meerstern/Usb_Camera_Converter/TestedCamera.csv

*共通注意点*
・SD,SDHC,SDXCまで対応していますが、確認は128GBまで確認済です。
・電源の電流が十分得られない場合、途中で停止する場合や再起動を繰り返す等不安定になる場合があります。1A以上供給可能な電源やUSBケーブルを使用してください。
・セルフパワーのUSBハブ等を介して十分な電流を確保してください。
・動作しないモードの場合にaltやdfi設定を変更することで動作する場合があります
*トリガかけてから保存までの時間を要する場合はdfi設定の値を小さく変更することで改善する場合があります
JpgScale | 0 | 160 | 120
 | 1 | 320 | 240
 | 2 | 640 | 480
 | 3 | 1280 | 960
Logicool C920 |  |  |  | HDMI Video Capture(MS2109) |  |  | ibuffolo BSWHD06M |  |  | Elecom UCAM-C520FBBK |  |  | Logicool C270 |  |  | Logicool C505
形式 | 解像度 | 動作有無 |  | 形式 | 解像度 | 動作有無 | 形式 | 解像度 | 動作有無 | 形式 | 解像度 | 動作有無 | 形式 | 解像度 | 動作有無 | 形式 | 解像度 | 動作有無
BMP | 160x90 | × |  | JPG | 1920x1080 | × | BMP | 320x240 | × | JPG | 1280x720 | 〇 | BMP | 160x120 | 〇 | BMP | 160x120 | 〇
BMP | 160x120 | × |  | JPG | 1600x1200 | × | BMP | 176x144 | 〇 | JPG | 800x600 | 〇 | BMP | 176x144 | 〇 | BMP | 176x144 | 〇
BMP | 176x144 | × |  | JPG | 1360x768 | × | BMP | 160x120 | 〇 | JPG | 640x480 | 〇 | BMP | 320x176 | 〇 | BMP | 320x176 | 〇
BMP | 320x180 | × |  | JPG | 1280x1024 | × | JPG | 1280x960 | 〇 | JPG | 352x288 | 〇 | BMP | 320x240 | 〇 | BMP | 320x240 | 〇
BMP | 320x240 | × |  | JPG | 1280x960 | × | JPG | 1280x720 | 〇 | *BMPはメモリ制約で動作せず |  |  | JPG | 640x480 | 〇 | JPG | 640x480 | 〇
JPG | 640x480 | × |  | JPG | 1280x720 | × | JPG | 800x600 | 〇 |  |  |  | JPG | 160x120 | 〇 | JPG | 160x120 | 〇
JPG | 160x90 | × |  | JPG | 1024x768 | × | JPG | 640x480 | 〇 |  |  |  | JPG | 176x144 | 〇 | JPG | 176x144 | 〇
JPG | 160x120 | × |  | JPG | 800x600 | × | JPG | 640x360 | 〇 |  |  |  | JPG | 320x176 | 〇 | JPG | 320x176 | 〇
JPG | 176x144 | × |  | JPG | 720x576 | × | JPG | 352x288 | 〇 |  |  |  | JPG | 320x240 | 〇 | JPG | 320x240 | 〇
JPG | 320x180 | × |  | JPG | 720x480 | × | JPG | 320x240 | 〇 |  |  |  | JPG | 352x288 | 〇 | JPG | 352x288 | 〇
JPG | 320x240 | × |  | JPG | 640x480 | × | JPG | 176x144 | 〇 |  |  |  | JPG | 432x240 | 〇 | JPG | 432x240 | 〇
JPG | 352x288 | × |  | *データ同期失敗するため、全フォーマットで動作せず |  |  | JPG | 160x120 | 〇 |  |  |  | JPG | 544x288 | 〇 | JPG | 544x288 | 〇
JPG | 432x240 | × |  |  |  |  | *数10回に1回程度、データ破損の場合有 |  |  |  |  |  | JPG | 640x360 | 〇 | JPG | 640x360 | 〇
JPG | 640x360 | × |  |  |  |  |  |  |  |  |  |  | JPG | 752x416 | 〇 | JPG | 752x416 | 〇
JPG | 800x448 | × |  |  |  |  |  |  |  |  |  |  | JPG | 800x448 | 〇 | JPG | 800x448 | 〇
JPG | 800x600 | 〇(alt=9) |  |  |  |  |  |  |  |  |  |  | JPG | 864x480 | 〇 | JPG | 864x480 | 〇
JPG | 864x480 | × |  |  |  |  |  |  |  |  |  |  | JPG | 960x544 | 〇 | JPG | 960x544 | 〇
JPG | 960x720 | × |  |  |  |  |  |  |  |  |  |  | JPG | 960x720 | 〇 | JPG | 960x720 | 〇
JPG | 1024x576 | 〇(alt=9) |  |  |  |  | *** Supported Stream Settings *** |  |  |  |  |  | JPG | 1024x576 | 〇 | JPG | 1024x576 | 〇
JPG | 1280x720 | × |  |  |  |  | Index:5, Format: 1(BMP 4), Frame: 6 (320 x 240) |  |  |  |  |  | JPG | 1184x656 | 〇 | JPG | 1184x656 | 〇
JPG | 1600x896 | × |  |  |  |  | Index:6, Format: 1(BMP 4), Frame: 7 (176 x 144) |  |  |  |  |  | JPG | 1280x720 | 〇 | JPG | 1280x720 | 〇
JPG | 1920x1080 | × |  |  |  |  | Index:7, Format: 1(BMP 4), Frame: 8 (160 x 120) |  |  |  |  |  | JPG | 1280x960 | 〇 | JPG | 1280x960 | 〇
*設定変更後のカメラ側のUSB差し直し必須 |  |  |  |  |  |  | Index:8, Format: 2(JPEG 6), Frame: 1 (1280 x 960)
*電流が大きいため、より安定した電源必須 |  |  |  |  |  |  | Index:9, Format: 2(JPEG 6), Frame: 2 (1280 x 720) |  |  |  |  |  | *電流が大きいため、より安定した電源必須 |  |  | *電流が大きいため、より安定した電源必須
 |  |  |  |  |  |  | Index:10, Format: 2(JPEG 6), Frame: 3 (800 x 600)
*atl=*記載はalt設定を変更することで動作 |  |  |  |  |  |  | Index:11, Format: 2(JPEG 6), Frame: 4 (640 x 480)
 |  |  |  |  |  |  | Index:12, Format: 2(JPEG 6), Frame: 5 (640 x 360) |  |  |  |  |  | *** Supported Stream Settings *** |  |  | *** Supported Stream Settings ***
 |  |  |  |  |  |  | Index:13, Format: 2(JPEG 6), Frame: 6 (352 x 288) |  |  |  |  |  | Index:1, Format: 1(BMP 4), Frame: 2 (160 x 120) |  |  | Index:1, Format: 1(BMP 4), Frame: 2 (160 x 120)
 |  |  |  |  |  |  | Index:14, Format: 2(JPEG 6), Frame: 7 (320 x 240) |  |  |  |  |  | Index:2, Format: 1(BMP 4), Frame: 3 (176 x 144) |  |  | Index:2, Format: 1(BMP 4), Frame: 3 (176 x 144)
 |  |  |  |  |  |  | Index:15, Format: 2(JPEG 6), Frame: 8 (176 x 144) |  |  |  |  |  | Index:3, Format: 1(BMP 4), Frame: 4 (320 x 176) |  |  | Index:3, Format: 1(BMP 4), Frame: 4 (320 x 176)
 |  |  |  |  |  |  | Index:16, Format: 2(JPEG 6), Frame: 9 (160 x 120) |  |  |  |  |  | Index:4, Format: 1(BMP 4), Frame: 5 (320 x 240) |  |  | Index:4, Format: 1(BMP 4), Frame: 5 (320 x 240)
 |  |  |  |  |  |  |  |  |  |  |  |  | Index:19, Format: 2(JPEG 6), Frame: 1 (640 x 480) |  |  | Index:19, Format: 2(JPEG 6), Frame: 1 (640 x 480)
 |  |  |  |  |  |  | *** Supported Alternate Interface *** |  |  |  |  |  | Index:20, Format: 2(JPEG 6), Frame: 2 (160 x 120) |  |  | Index:20, Format: 2(JPEG 6), Frame: 2 (160 x 120)
 |  |  |  |  |  |  | Index:2, Size: 0xC00 byte |  |  |  |  |  | Index:21, Format: 2(JPEG 6), Frame: 3 (176 x 144) |  |  | Index:21, Format: 2(JPEG 6), Frame: 3 (176 x 144)
 |  |  |  |  |  |  | Index:3, Size: 0x400 byte |  |  |  |  |  | Index:22, Format: 2(JPEG 6), Frame: 4 (320 x 176) |  |  | Index:22, Format: 2(JPEG 6), Frame: 4 (320 x 176)
 |  |  |  |  |  |  | Index:4, Size: 0x200 byte |  |  |  |  |  | Index:23, Format: 2(JPEG 6), Frame: 5 (320 x 240) |  |  | Index:23, Format: 2(JPEG 6), Frame: 5 (320 x 240)
 |  |  |  |  |  |  |  |  |  |  |  |  | Index:24, Format: 2(JPEG 6), Frame: 6 (352 x 288) |  |  | Index:24, Format: 2(JPEG 6), Frame: 6 (352 x 288)
 |  |  |  |  |  |  | *** Supported Dataframe Interval *** |  |  |  |  |  | Index:25, Format: 2(JPEG 6), Frame: 7 (432 x 240) |  |  | Index:25, Format: 2(JPEG 6), Frame: 7 (432 x 240)
 |  |  |  |  |  |  | Index:1, Interval: 0x1312D0 msec |  |  |  |  |  | Index:26, Format: 2(JPEG 6), Frame: 8 (544 x 288) |  |  | Index:26, Format: 2(JPEG 6), Frame: 8 (544 x 288)
 |  |  |  |  |  |  |  |  |  |  |  |  | Index:27, Format: 2(JPEG 6), Frame: 9 (640 x 360) |  |  | Index:27, Format: 2(JPEG 6), Frame: 9 (640 x 360)
 |  |  |  |  |  |  |  |  |  |  |  |  | Index:28, Format: 2(JPEG 6), Frame: 10 (752 x 416) |  |  | Index:28, Format: 2(JPEG 6), Frame: 10 (752 x 416)
 |  |  |  |  |  |  |  |  |  |  |  |  | Index:29, Format: 2(JPEG 6), Frame: 11 (800 x 448) |  |  | Index:29, Format: 2(JPEG 6), Frame: 11 (800 x 448)
 |  |  |  |  |  |  |  |  |  |  |  |  | Index:30, Format: 2(JPEG 6), Frame: 12 (800 x 600) |  |  | Index:30, Format: 2(JPEG 6), Frame: 12 (800 x 600)
 |  |  |  |  |  |  |  |  |  |  |  |  | Index:31, Format: 2(JPEG 6), Frame: 13 (864 x 480) |  |  | Index:31, Format: 2(JPEG 6), Frame: 13 (864 x 480)
 |  |  |  |  |  |  |  |  |  |  |  |  | Index:32, Format: 2(JPEG 6), Frame: 14 (960 x 544) |  |  | Index:32, Format: 2(JPEG 6), Frame: 14 (960 x 544)
 |  |  |  |  |  |  |  |  |  |  |  |  | Index:33, Format: 2(JPEG 6), Frame: 15 (960 x 720) |  |  | Index:33, Format: 2(JPEG 6), Frame: 15 (960 x 720)
 |  |  |  |  |  |  |  |  |  |  |  |  | Index:34, Format: 2(JPEG 6), Frame: 16 (1024 x 576) |  |  | Index:34, Format: 2(JPEG 6), Frame: 16 (1024 x 576)
 |  |  |  |  |  |  |  |  |  |  |  |  | Index:35, Format: 2(JPEG 6), Frame: 17 (1184 x 656) |  |  | Index:35, Format: 2(JPEG 6), Frame: 17 (1184 x 656)
 |  |  |  |  |  |  |  |  |  |  |  |  | Index:36, Format: 2(JPEG 6), Frame: 18 (1280 x 720) |  |  | Index:36, Format: 2(JPEG 6), Frame: 18 (1280 x 720)
 |  |  |  |  |  |  |  |  |  |  |  |  | Index:37, Format: 2(JPEG 6), Frame: 19 (1280 x 960) |  |  | Index:37, Format: 2(JPEG 6), Frame: 19 (1280 x 960)
 |  |  |  |  |  |  |  |  |  |  |  |  | *** Supported Alternate Interface *** |  |  | *** Supported Alternate Interface ***
 |  |  |  |  |  |  |  |  |  |  |  |  | Index:1, Size: 0xC0 byte |  |  | Index:1, Size: 0xC0 byte
 |  |  |  |  |  |  |  |  |  |  |  |  | Index:2, Size: 0x180 byte |  |  | Index:2, Size: 0x180 byte
 |  |  |  |  |  |  |  |  |  |  |  |  | Index:3, Size: 0x200 byte |  |  | Index:3, Size: 0x200 byte
 |  |  |  |  |  |  |  |  |  |  |  |  | Index:4, Size: 0x280 byte |  |  | Index:4, Size: 0x280 byte
 |  |  |  |  |  |  |  |  |  |  |  |  | Index:5, Size: 0x320 byte |  |  | Index:5, Size: 0x320 byte
 |  |  |  |  |  |  |  |  |  |  |  |  | Index:6, Size: 0x3B0 byte |  |  | Index:6, Size: 0x3B0 byte
 |  |  |  |  |  |  |  |  |  |  |  |  | Index:7, Size: 0xA80 byte |  |  | Index:7, Size: 0xA80 byte
 |  |  |  |  |  |  |  |  |  |  |  |  | Index:8, Size: 0xB20 byte |  |  | Index:8, Size: 0xB20 byte
 |  |  |  |  |  |  |  |  |  |  |  |  | Index:9, Size: 0xBE0 byte |  |  | Index:9, Size: 0xBE0 byte
 |  |  |  |  |  |  |  |  |  |  |  |  | *** Supported Dataframe Interval *** |  |  | *** Supported Dataframe Interval ***
 |  |  |  |  |  |  |  |  |  |  |  |  | Index:1, Interval: 0x51615 msec |  |  | Index:1, Interval: 0x51615 msec
 |  |  |  |  |  |  |  |  |  |  |  |  | Index:2, Interval: 0x61A80 msec |  |  | Index:2, Interval: 0x61A80 msec
 |  |  |  |  |  |  |  |  |  |  |  |  | Index:3, Interval: 0x7A120 msec |  |  | Index:3, Interval: 0x7A120 msec
 |  |  |  |  |  |  |  |  |  |  |  |  | Index:4, Interval: 0xA2C2A msec |  |  | Index:4, Interval: 0xA2C2A msec
 |  |  |  |  |  |  |  |  |  |  |  |  | Index:5, Interval: 0xF4240 msec |  |  | Index:5, Interval: 0xF4240 msec
 |  |  |  |  |  |  |  |  |  |  |  |  | Index:6, Interval: 0x1E8480 msec |  |  | Index:6, Interval: 0x1E8480 msec
