meerstern/Usb_Camera_Converter/PCB/Circuit.pdf

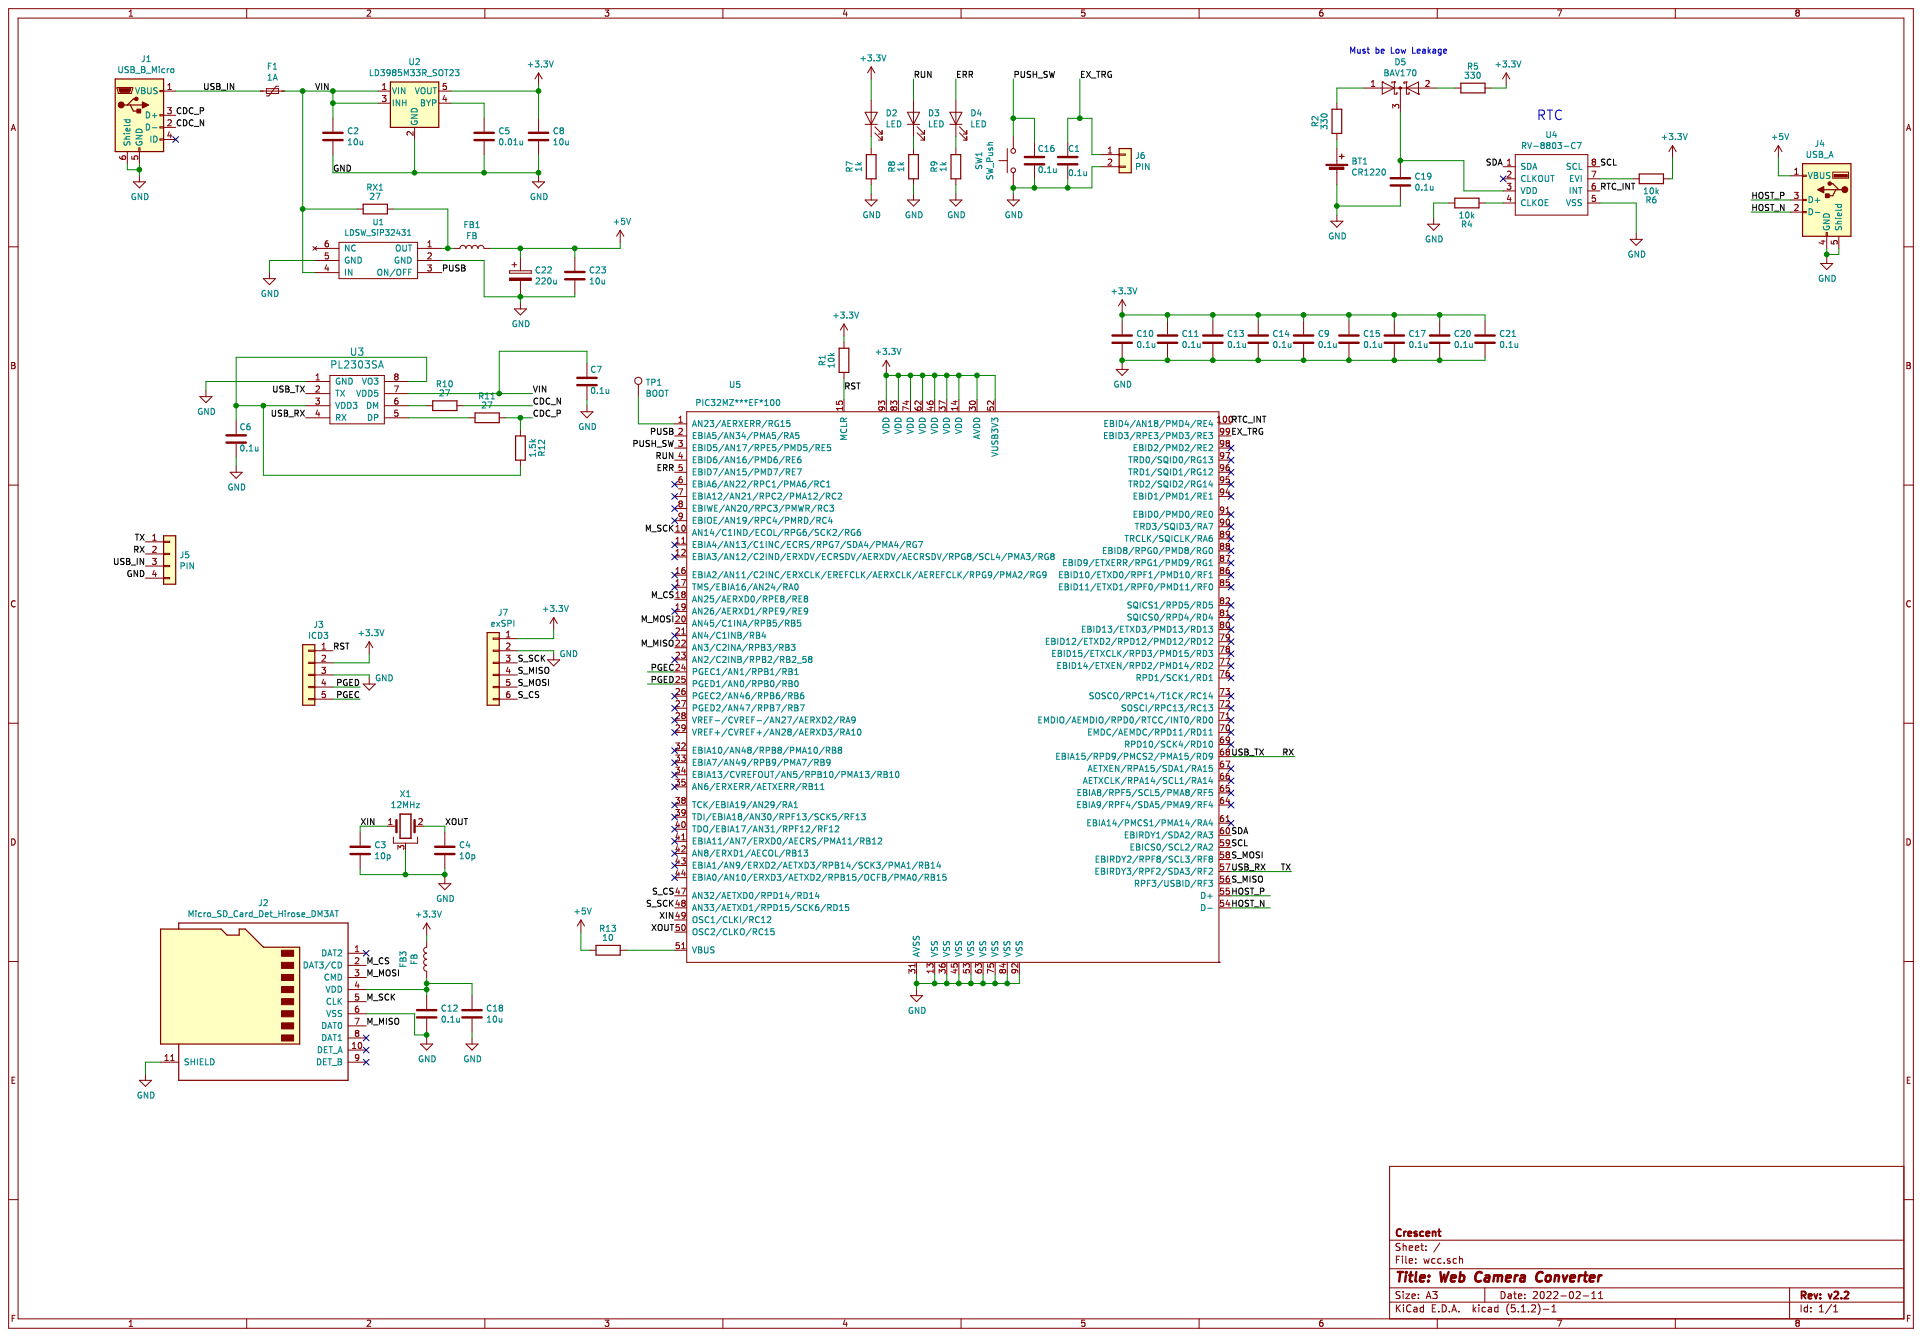
[picture p8: page 1]
