meerstern/Usb_Camera_Converter/(list of files, drawings)

Other design files:
PCB/wcc.dsn
