meerstern/Usb_Camera_Converter/PCB/wcc.kicad_pcb

## KiCad design PCB/wcc.kicad_pcb (2022-03-23)

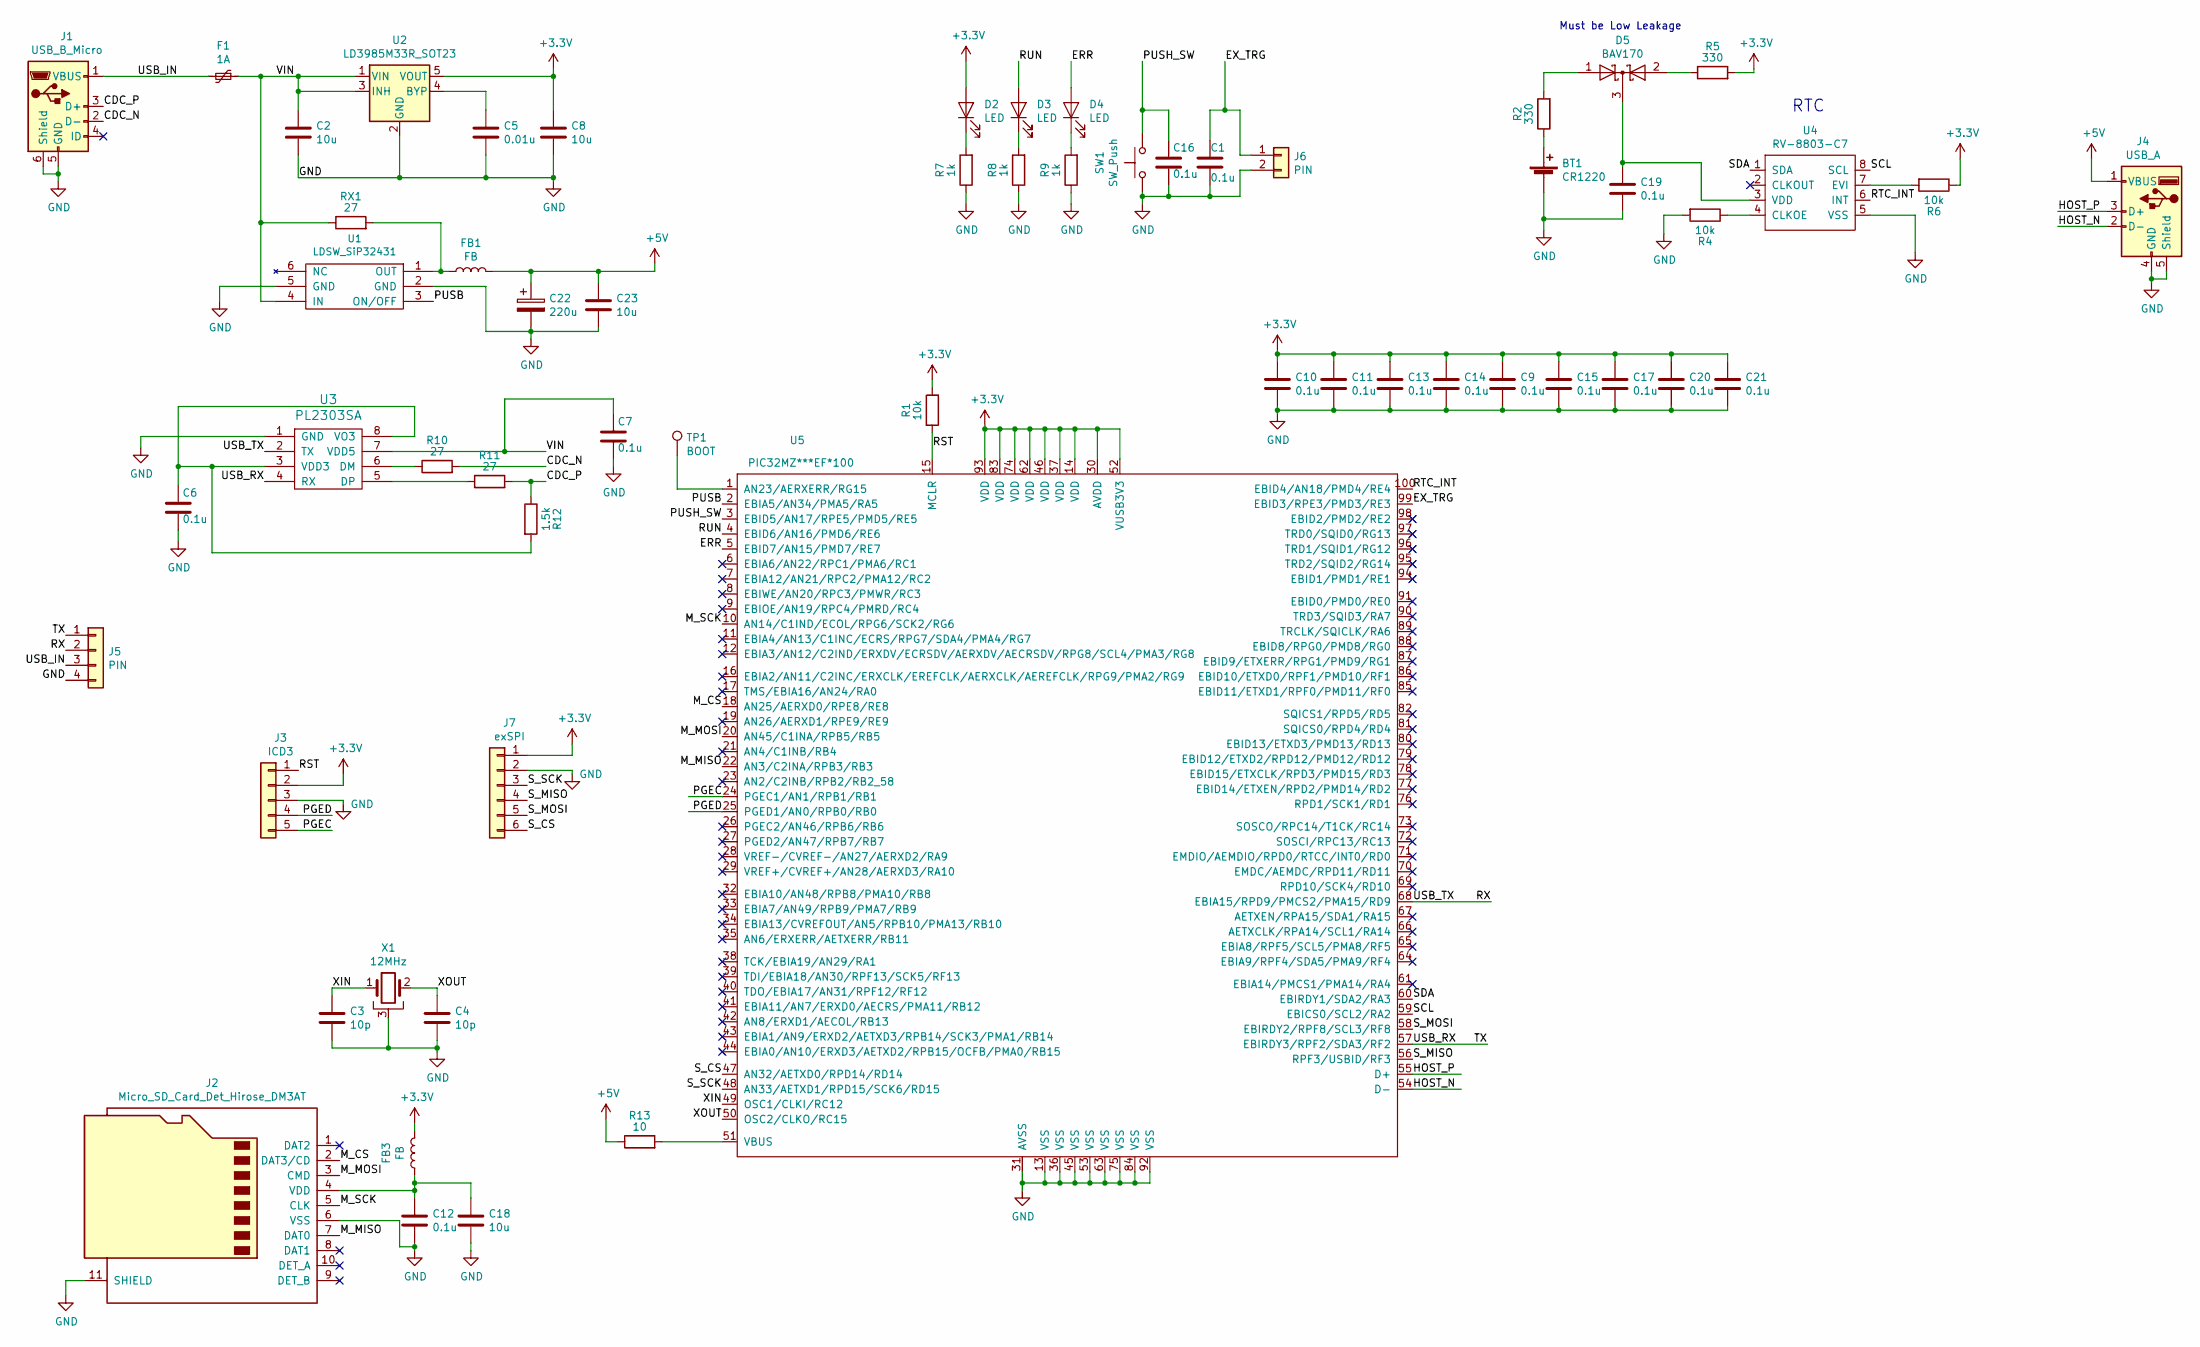
[picture p9: schematic wcc.sch, Web Camera Converter]

Parts:
BT1: CR1220; 2895
C1, C6, C7, C9, C10, C11, C12, C13, C14, C15, C16, C17, C19, C20, C21: 0.1u; C_0603_1608Metric
C2, C8, C18, C23: 10u; C_0805_2012Metric
C3, C4: 10p; C_0603_1608Metric
C5: 0.01u; C_0603_1608Metric
C22: 220u; CP_Elec_6.3x5.4_Nichicon
D2, D3, D4: LED; D_0603_1608Metric
D5: BAV170; SOT-23
F1: 1A; Fuse_1210_3225Metric
FB1, FB3: FB; L_0603_1608Metric
J1: USB_B_Micro; CONN-10118194-0001LF-FCI
J2: Micro_SD_Card_Det_Hirose_DM3AT; microSD_HC_Hirose_DM3AT-SF-PEJM5
J3: ICD3; PinHeader_1x05_P2.54mm_Vertical
J4: USB_A; USBHOST
J5: PIN; PinHeader_1x04_P2.54mm_Vertical
J6: PIN; PinHeader_1x02_P2.54mm_Vertical
J7: exSPI; PinHeader_1x06_P2.54mm_Vertical
R1, R4, R6: 10k; R_0603_1608Metric
R2, R5: 330; R_0603_1608Metric
R7, R8, R9: 1k; R_0603_1608Metric
R10, R11: 27; R_0603_1608Metric
R12: 1.5k; R_0603_1608Metric
R13: 10; R_0603_1608Metric
RX1: 27; R_0603_1608Metric
SW1: SW_Push; SKRPACE010
TP1: BOOT; TestPoint_Pad_D1.0mm
U1: LDSW_SiP32431; SOT-363_SC-70-6
U2: LD3985M33R_SOT23; SOT-23-5
U3: PL2303SA; SOIC-8_3.9x4.9mm_P1.27mm
U4: RV-8803-C7
U5: PIC32MZ***EF*100; TQFP-100_12x12mm_P0.4mm
X1: 12MHz; FA238V

Connections:
+3V3: C8.1, C9.1, C10.1, C11.1, C13.1, C14.1, C15.1, C17.1, C20.1, C21.1, D2.2 (A), FB3.2, J3.2, J7.1, R1.2, R5.2, R6.1, U2.5 (VOUT), U5.14 (VDD), U5.30 (AVDD), U5.37 (VDD), U5.46 (VDD), U5.52 (VUSB3V3), U5.62 (VDD), U5.74 (VDD), U5.83 (VDD), U5.93 (VDD)
+5V: C22.1, C23.1, FB1.2, J4.1 (VBUS), R13.1
/CDC_N: J1.2 (D-), R10.2
/CDC_P: J1.3 (D+), R11.2, R12.1
/ERR: D4.2 (A), U5.5 (EBID7/AN15/PMD7/RE7)
/EX_TRG: C1.1, J6.1, U5.99 (EBID3/RPE3/PMD3/RE3)
/HOST_N: J4.2 (D-), U5.54 (D-)
/HOST_P: J4.3 (D+), U5.55 (D+)
/M_CS: J2.2 (DAT3/CD), U5.18 (AN25/AERXD0/RPE8/RE8)
/M_MISO: J2.7 (DAT0), U5.22 (AN3/C2INA/RPB3/RB3)
/M_MOSI: J2.3 (CMD), U5.20 (AN45/C1INA/RPB5/RB5)
/M_SCK: J2.5 (CLK), U5.10 (AN14/C1IND/ECOL/RPG6/SCK2/RG6)
/PGEC: J3.5, U5.24 (PGEC1/AN1/RPB1/RB1)
/PGED: J3.4, U5.25 (PGED1/AN0/RPB0/RB0)
/PUSB: U1.3 (ON/OFF), U5.2 (EBIA5/AN34/PMA5/RA5)
/PUSH_SW: C16.1, SW1.2, U5.3 (EBID5/AN17/RPE5/PMD5/RE5)
/RST: J3.1, R1.1, U5.15 (MCLR)
/RTC_INT: U4.6 (INT), U5.100 (EBID4/AN18/PMD4/RE4)
/RUN: D3.2 (A), U5.4 (EBID6/AN16/PMD6/RE6)
/RX: J5.2, U3.2 (TX), U5.68 (EBIA15/RPD9/PMCS2/PMA15/RD9)
/SCL: U4.8 (SCL), U5.59 (EBICS0/SCL2/RA2)
/SDA: U4.1 (SDA), U5.60 (EBIRDY1/SDA2/RA3)
/S_CS: J7.6, U5.47 (AN32/AETXD0/RPD14/RD14)
/S_MISO: J7.4, U5.56 (RPF3/USBID/RF3)
/S_MOSI: J7.5, U5.58 (EBIRDY2/RPF8/SCL3/RF8)
/S_SCK: J7.3, U5.48 (AN33/AETXD1/RPD15/SCK6/RD15)
/TX: J5.1, U3.4 (RX), U5.57 (EBIRDY3/RPF2/SDA3/RF2)
/USB_IN: F1.2, J1.1 (VBUS), J5.3
/VIN: C2.1, C7.1, F1.1, RX1.1, U1.4 (IN), U2.1 (VIN), U2.3 (INH), U3.7 (VDD5)
/XIN: C3.1, U5.49 (OSC1/CLKI/RC12), X1.1
/XOUT: C4.1, U5.50 (OSC2/CLKO/RC15), X1.2
GND: BT1.2 (-), C1.2, C2.2, C3.2, C4.2, C5.2, C6.2, C7.2, C8.2, C9.2, C10.2, C11.2, C12.2, C13.2, C14.2, C15.2, C16.2, C17.2, C18.2, C19.2, C20.2, C21.2, C22.2, C23.2, J1.5 (GND), J1.6 (Shield), J2.6 (VSS), J2.11 (SHIELD), J3.3, J4.4 (GND), J4.5 (Shield), J5.4, J6.2, J7.2, R4.2, R7.1, R8.1, R9.1, SW1.1, U1.2 (GND), U1.5 (GND), U2.2 (GND), U3.1 (GND), U4.5 (VSS), U5.13 (VSS), U5.31 (AVSS), U5.36 (VSS), U5.45 (VSS), U5.53 (VSS), U5.63 (VSS), U5.75 (VSS), U5.84 (VSS), U5.92 (VSS), X1.3
unnamed: BT1.1 (+), R2.1
unnamed: C5.1, U2.4 (BYP)
unnamed: C6.1, R12.2, U3.3 (VDD3), U3.8 (VO3)
unnamed: C12.1, C18.1, FB3.1, J2.4 (VDD)
unnamed: C19.1, D5.3 (K), U4.3 (VDD)
unnamed: D2.1 (K), R7.2
unnamed: D3.1 (K), R8.2
unnamed: D4.1 (K), R9.2
unnamed: D5.1 (A), R2.2
unnamed: D5.2 (A), R5.1
unnamed: FB1.1, RX1.2, U1.1 (OUT)
unnamed: R4.1, U4.4 (CLKOE)
unnamed: R6.2, U4.7 (EVI)
unnamed: R10.1, U3.6 (DM)
unnamed: R11.1, U3.5 (DP)
unnamed: R13.2, U5.51 (VBUS)
unnamed: TP1.1, U5.1 (AN23/AERXERR/RG15)

Notes on the sheet:
RTC
Must be Low Leakage

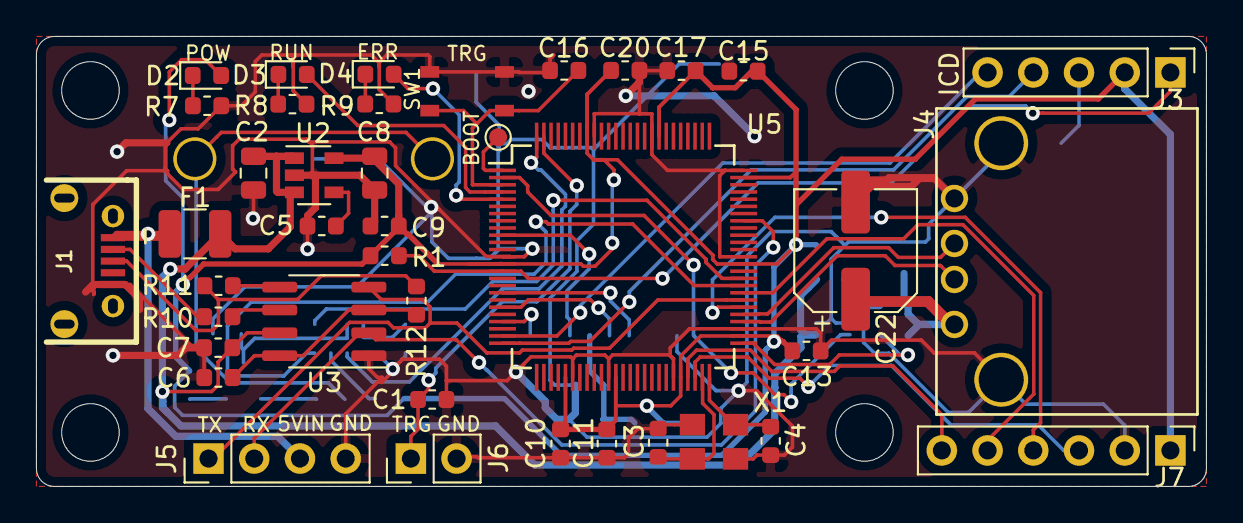
[picture p10: board wcc.kicad_pcb from above]

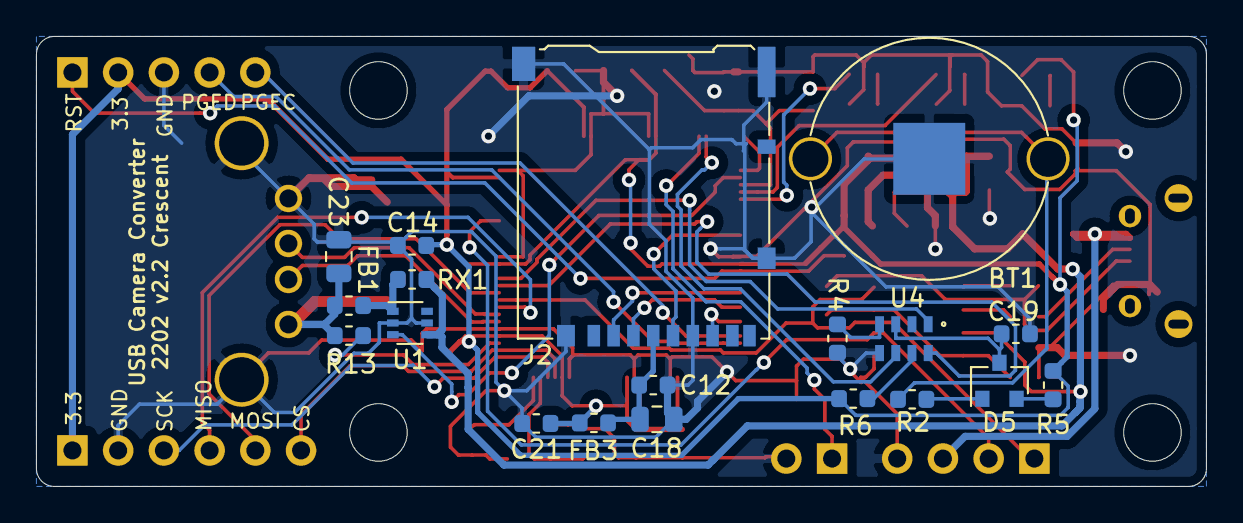
[picture p11: board wcc.kicad_pcb from below]

Board: 2 copper layers, 65.0 x 25.0 mm, 63 parts (19 on the bottom side), 49 nets.

Other parts of the board:
REF1, REF2, REF3, REF4: MountingHole_3.2mm_M3
