meerstern/Usb_Camera_Converter/FIRM/Application/firmware/src/config/default/initialization.c

/*******************************************************************************
  System Initialization File

  File Name:
    initialization.c

  Summary:
    This file contains source code necessary to initialize the system.

  Description:
    This file contains source code necessary to initialize the system.  It
    implements the "SYS_Initialize" function, defines the configuration bits,
    and allocates any necessary global system resources,
 *******************************************************************************/

// DOM-IGNORE-BEGIN
/*******************************************************************************
* Copyright (C) 2018 Microchip Technology Inc. and its subsidiaries.
*
* Subject to your compliance with these terms, you may use Microchip software
* and any derivatives exclusively with Microchip products. It is your
* responsibility to comply with third party license terms applicable to your
* use of third party software (including open source software) that may
* accompany Microchip software.
*
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
* IN NO EVENT WILL MICROCHIP BE LIABLE FOR ANY INDIRECT, SPECIAL, PUNITIVE,
* INCIDENTAL OR CONSEQUENTIAL LOSS, DAMAGE, COST OR EXPENSE OF ANY KIND
* WHATSOEVER RELATED TO THE SOFTWARE, HOWEVER CAUSED, EVEN IF MICROCHIP HAS
* BEEN ADVISED OF THE POSSIBILITY OR THE DAMAGES ARE FORESEEABLE. TO THE
* FULLEST EXTENT ALLOWED BY LAW, MICROCHIP'S TOTAL LIABILITY ON ALL CLAIMS IN
* ANY WAY RELATED TO THIS SOFTWARE WILL NOT EXCEED THE AMOUNT OF FEES, IF ANY,
* THAT YOU HAVE PAID DIRECTLY TO MICROCHIP FOR THIS SOFTWARE.
 *******************************************************************************/
// DOM-IGNORE-END

// *****************************************************************************
// *****************************************************************************
// Section: Included Files
// *****************************************************************************
// *****************************************************************************
#include "configuration.h"
#include "definitions.h"
#include "device.h"
#include "driver/spi/src/drv_spi_local.h"


// ****************************************************************************
// ****************************************************************************
// Section: Configuration Bits
// ****************************************************************************
// ****************************************************************************

/*** DEVCFG0 ***/
#pragma config DEBUG =      OFF
#pragma config JTAGEN =     OFF
#pragma config ICESEL =     ICS_PGx1
#pragma config TRCEN =      OFF
#pragma config BOOTISA =    MIPS32
#pragma config FECCCON =    OFF_UNLOCKED
#pragma config FSLEEP =     OFF
#pragma config DBGPER =     PG_ALL
#pragma config SMCLR =      MCLR_NORM
#pragma config SOSCGAIN =   GAIN_LEVEL_3
#pragma config SOSCBOOST =  ON
#pragma config POSCGAIN =   GAIN_LEVEL_3
#pragma config POSCBOOST =  ON
#pragma config EJTAGBEN =   NORMAL
#pragma config CP =         OFF

/*** DEVCFG1 ***/
#pragma config FNOSC =      SPLL
#pragma config DMTINTV =    WIN_127_128
#pragma config FSOSCEN =    OFF
#pragma config IESO =       OFF
#pragma config POSCMOD =    HS
#pragma config OSCIOFNC =   OFF
#pragma config FCKSM =      CSECME
#pragma config WDTPS =      PS16384
#pragma config WDTSPGM =    STOP
#pragma config FWDTEN =     OFF
#pragma config WINDIS =     NORMAL
#pragma config FWDTWINSZ =  WINSZ_25
#pragma config DMTCNT =     DMT31
#pragma config FDMTEN =     OFF

/*** DEVCFG2 ***/
#pragma config FPLLIDIV =   DIV_1
#pragma config FPLLRNG =    RANGE_5_10_MHZ
#pragma config FPLLICLK =   PLL_FRC
#pragma config FPLLMULT =   MUL_50
#pragma config FPLLODIV =   DIV_2
#pragma config UPLLFSEL =   FREQ_12MHZ

/*** DEVCFG3 ***/
#pragma config USERID =     0xffff
#pragma config FMIIEN =     OFF
#pragma config FETHIO =     OFF
#pragma config PGL1WAY =    OFF
#pragma config PMDL1WAY =   OFF
#pragma config IOL1WAY =    OFF
#pragma config FUSBIDIO =   OFF

/*** BF1SEQ0 ***/

#pragma config TSEQ =       0xffff
#pragma config CSEQ =       0x0





// *****************************************************************************
// *****************************************************************************
// Section: Driver Initialization Data
// *****************************************************************************
// *****************************************************************************
// <editor-fold defaultstate="collapsed" desc="DRV_SDSPI Instance 0 Initialization Data">

/* SDSPI Client Objects Pool */
static DRV_SDSPI_CLIENT_OBJ drvSDSPI0ClientObjPool[DRV_SDSPI_CLIENTS_NUMBER_IDX0];

/* SDSPI Transfer Objects Pool */
static DRV_SDSPI_BUFFER_OBJ drvSDSPI0TransferObjPool[DRV_SDSPI_QUEUE_SIZE_IDX0];

/* SPI PLIB Interface Initialization for SDSPI Driver */
const DRV_SDSPI_PLIB_INTERFACE drvSDSPI0PlibAPI = {

    /* SPI PLIB WriteRead function */
    .writeRead = (DRV_SDSPI_PLIB_WRITEREAD)SPI2_WriteRead,

    /* SPI PLIB Write function */
    .write = (DRV_SDSPI_PLIB_WRITE)SPI2_Write,

    /* SPI PLIB Read function */
    .read = (DRV_SDSPI_PLIB_READ)SPI2_Read,

    /* SPI PLIB Transfer Status function */
    .isBusy = (DRV_SDSPI_PLIB_IS_BUSY)SPI2_IsBusy,

    .transferSetup = (DRV_SDSPI_PLIB_SETUP)SPI2_TransferSetup,

    /* SPI PLIB Callback Register */
    .callbackRegister = (DRV_SDSPI_PLIB_CALLBACK_REGISTER)SPI2_CallbackRegister,
};

const uint32_t drvSDSPI0remapDataBits[]= { 0x00000000, 0xFFFFFFFF, 0xFFFFFFFF, 0xFFFFFFFF, 0xFFFFFFFF, 0xFFFFFFFF, 0xFFFFFFFF, 0xFFFFFFFF, 0x00000400 };
const uint32_t drvSDSPI0remapClockPolarity[] = { 0x00000000, 0x00000040 };
const uint32_t drvSDSPI0remapClockPhase[] = { 0x00000000, 0x00000100 };

/* SDSPI Driver Initialization Data */
const DRV_SDSPI_INIT drvSDSPI0InitData =
{
    /* SD Card SPI PLIB API interface*/
    .spiPlib                = &drvSDSPI0PlibAPI,

    .remapDataBits          = drvSDSPI0remapDataBits,

    .remapClockPolarity     = drvSDSPI0remapClockPolarity,

    .remapClockPhase        = drvSDSPI0remapClockPhase,


    /* SDSPI Number of clients */
    .numClients             = DRV_SDSPI_CLIENTS_NUMBER_IDX0,

    /* SDSPI Client Objects Pool */
    .clientObjPool          = (uintptr_t)&drvSDSPI0ClientObjPool[0],

    /* SDSPI Transfer Objects Pool */
    .bufferObjPool          = (uintptr_t)&drvSDSPI0TransferObjPool[0],

    /* SDSPI Transfer Objects Queue Size */
    .bufferObjPoolSize      = DRV_SDSPI_QUEUE_SIZE_IDX0,

    .chipSelectPin          = DRV_SDSPI_CHIP_SELECT_PIN_IDX0,

    .sdcardSpeedHz          = DRV_SDSPI_SPEED_HZ_IDX0,

    .pollingIntervalMs      = DRV_SDSPI_POLLING_INTERVAL_MS_IDX0,

    .writeProtectPin        = SYS_PORT_PIN_NONE,

    .isFsEnabled            = true,

    /* DMA Channel for Transmit */
    .txDMAChannel           = DRV_SDSPI_XMIT_DMA_CH_IDX0,

    /* DMA Channel for Receive */
    .rxDMAChannel           = DRV_SDSPI_RCV_DMA_CH_IDX0,

    /* SPI Transmit Register */
    .txAddress              = (void *)&(SPI2BUF),

    /* SPI Receive Register */
    .rxAddress              = (void *)&(SPI2BUF),
};

// </editor-fold>

// <editor-fold defaultstate="collapsed" desc="DRV_SPI Instance 0 Initialization Data">

/* SPI Client Objects Pool */
static DRV_SPI_CLIENT_OBJ drvSPI0ClientObjPool[DRV_SPI_CLIENTS_NUMBER_IDX0];

/* SPI Transfer Objects Pool */
static DRV_SPI_TRANSFER_OBJ drvSPI0TransferObjPool[DRV_SPI_QUEUE_SIZE_IDX0];

/* SPI PLIB Interface Initialization */
const DRV_SPI_PLIB_INTERFACE drvSPI0PlibAPI = {

    /* SPI PLIB Setup */
    .setup = (DRV_SPI_PLIB_SETUP)SPI6_TransferSetup,

    /* SPI PLIB WriteRead function */
    .writeRead = (DRV_SPI_PLIB_WRITE_READ)SPI6_WriteRead,

    /* SPI PLIB Transfer Status function */
    .isBusy = (DRV_SPI_PLIB_IS_BUSY)SPI6_IsBusy,

    /* SPI PLIB Callback Register */
    .callbackRegister = (DRV_SPI_PLIB_CALLBACK_REGISTER)SPI6_CallbackRegister,
};

const uint32_t drvSPI0remapDataBits[]= { 0x00000000, 0xFFFFFFFF, 0xFFFFFFFF, 0xFFFFFFFF, 0xFFFFFFFF, 0xFFFFFFFF, 0xFFFFFFFF, 0xFFFFFFFF, 0x00000400 };
const uint32_t drvSPI0remapClockPolarity[] = { 0x00000000, 0x00000040 };
const uint32_t drvSPI0remapClockPhase[] = { 0x00000000, 0x00000100 };

const DRV_SPI_INTERRUPT_SOURCES drvSPI0InterruptSources =
{
    /* Peripheral has more than one interrupt vectors */
    .isSingleIntSrc                        = false,

    /* Peripheral interrupt lines */
    .intSources.multi.spiTxReadyInt      = -1,
    .intSources.multi.spiTxCompleteInt   = _SPI6_TX_VECTOR,
    .intSources.multi.spiRxInt           = _SPI6_RX_VECTOR,
};

/* SPI Driver Initialization Data */
const DRV_SPI_INIT drvSPI0InitData =
{
    /* SPI PLIB API */
    .spiPlib = &drvSPI0PlibAPI,

    .remapDataBits = drvSPI0remapDataBits,

    .remapClockPolarity = drvSPI0remapClockPolarity,

    .remapClockPhase = drvSPI0remapClockPhase,

    /* SPI Number of clients */
    .numClients = DRV_SPI_CLIENTS_NUMBER_IDX0,

    /* SPI Client Objects Pool */
    .clientObjPool = (uintptr_t)&drvSPI0ClientObjPool[0],

    /* DMA Channel for Transmit */
    .dmaChannelTransmit = SYS_DMA_CHANNEL_NONE,

    /* DMA Channel for Receive */
    .dmaChannelReceive  = SYS_DMA_CHANNEL_NONE,

    /* SPI Queue Size */
    .transferObjPoolSize = DRV_SPI_QUEUE_SIZE_IDX0,

    /* SPI Transfer Objects Pool */
    .transferObjPool = (uintptr_t)&drvSPI0TransferObjPool[0],

    /* SPI interrupt sources (SPI peripheral and DMA) */
    .interruptSources = &drvSPI0InterruptSources,
};

// </editor-fold>


// *****************************************************************************
// *****************************************************************************
// Section: System Data
// *****************************************************************************
// *****************************************************************************
/* Structure to hold the object handles for the modules in the system. */
SYSTEM_OBJECTS sysObj;

// *****************************************************************************
// *****************************************************************************
// Section: Library/Stack Initialization Data
// *****************************************************************************
// *****************************************************************************
/******************************************************
 * USB Driver Initialization
 ******************************************************/
//uint8_t __attribute__((aligned(512))) endPointTable1[DRV_USBHS_ENDPOINTS_NUMBER * 32];


const DRV_USBHS_INIT drvUSBInit =
{
    /* Assign the endpoint table */
    //.endpointTable= endPointTable1,
    
    /* Interrupt Source for USB module */
    .interruptSource = INT_SOURCE_USB,

	/* Interrupt Source for USB module */
    .interruptSourceUSBDma = INT_SOURCE_USB_DMA,
	
    /* System module initialization */
    .moduleInit = {0},

	/* USB Controller to operate as USB Host */
    .operationMode = DRV_USBHS_OPMODE_HOST,

	/* Enable High Speed Operation */
    .operationSpeed = USB_SPEED_HIGH,
    
    /* Stop in idle */
    .stopInIdle = true,

    /* Suspend in sleep */
    .suspendInSleep = false,

    /* Identifies peripheral (PLIB-level) ID */
    .usbID = USBHS_ID_0,
	
	.portPowerEnable = NULL,
	
    /* Root hub available current in milliamperes */
    .rootHubAvailableCurrent = 500,
};


// <editor-fold defaultstate="collapsed" desc="File System Initialization Data">


const SYS_FS_MEDIA_MOUNT_DATA sysfsMountTable[SYS_FS_VOLUME_NUMBER] =
{
    {NULL}
};

const SYS_FS_FUNCTIONS FatFsFunctions =
{
    .mount             = FATFS_mount,
    .unmount           = FATFS_unmount,
    .open              = FATFS_open,
    .read              = FATFS_read,
    .close             = FATFS_close,
    .seek              = FATFS_lseek,
    .fstat             = FATFS_stat,
    .getlabel          = FATFS_getlabel,
    .currWD            = FATFS_getcwd,
    .getstrn           = FATFS_gets,
    .openDir           = FATFS_opendir,
    .readDir           = FATFS_readdir,
    .closeDir          = FATFS_closedir,
    .chdir             = FATFS_chdir,
    .chdrive           = FATFS_chdrive,
    .write             = FATFS_write,
    .tell              = FATFS_tell,
    .eof               = FATFS_eof,
    .size              = FATFS_size,
    .mkdir             = FATFS_mkdir,
    .remove            = FATFS_unlink,
    .setlabel          = FATFS_setlabel,
    .truncate          = FATFS_truncate,
    .chmode            = FATFS_chmod,
    .chtime            = FATFS_utime,
    .rename            = FATFS_rename,
    .sync              = FATFS_sync,
    .putchr            = FATFS_putc,
    .putstrn           = FATFS_puts,
    .formattedprint    = FATFS_printf,
    .testerror         = FATFS_error,
    .formatDisk        = (FORMAT_DISK)FATFS_mkfs,
    .partitionDisk     = FATFS_fdisk,
    .getCluster        = FATFS_getclusters
};


const SYS_FS_REGISTRATION_TABLE sysFSInit [ SYS_FS_MAX_FILE_SYSTEM_TYPE ] =
{
    {
        .nativeFileSystemType = FAT,
        .nativeFileSystemFunctions = &FatFsFunctions
    }
};

// </editor-fold>



// *****************************************************************************
// *****************************************************************************
// Section: System Initialization
// *****************************************************************************
// *****************************************************************************

const SYS_DEBUG_INIT debugInit =
{
    .moduleInit = {0},
    .errorLevel = SYS_DEBUG_GLOBAL_ERROR_LEVEL,
    .consoleIndex = 0,
};


// <editor-fold defaultstate="collapsed" desc="SYS_TIME Initialization Data">

const SYS_TIME_PLIB_INTERFACE sysTimePlibAPI = {
    .timerCallbackSet = (SYS_TIME_PLIB_CALLBACK_REGISTER)CORETIMER_CallbackSet,
    .timerStart = (SYS_TIME_PLIB_START)CORETIMER_Start,
    .timerStop = (SYS_TIME_PLIB_STOP)CORETIMER_Stop ,
    .timerFrequencyGet = (SYS_TIME_PLIB_FREQUENCY_GET)CORETIMER_FrequencyGet,
    .timerPeriodSet = (SYS_TIME_PLIB_PERIOD_SET)NULL,
    .timerCompareSet = (SYS_TIME_PLIB_COMPARE_SET)CORETIMER_CompareSet,
    .timerCounterGet = (SYS_TIME_PLIB_COUNTER_GET)CORETIMER_CounterGet,
};

const SYS_TIME_INIT sysTimeInitData =
{
    .timePlib = &sysTimePlibAPI,
    .hwTimerIntNum = 0,
};

// </editor-fold>
// <editor-fold defaultstate="collapsed" desc="SYS_CONSOLE Instance 0 Initialization Data">


/* Declared in console device implementation (sys_console_uart.c) */
extern const SYS_CONSOLE_DEV_DESC sysConsoleUARTDevDesc;

const SYS_CONSOLE_UART_PLIB_INTERFACE sysConsole0UARTPlibAPI =
{
    .read = (SYS_CONSOLE_UART_PLIB_READ)UART2_Read,
	.readCountGet = (SYS_CONSOLE_UART_PLIB_READ_COUNT_GET)UART2_ReadCountGet,
	.readFreeBufferCountGet = (SYS_CONSOLE_UART_PLIB_READ_FREE_BUFFFER_COUNT_GET)UART2_ReadFreeBufferCountGet,
    .write = (SYS_CONSOLE_UART_PLIB_WRITE)UART2_Write,
	.writeCountGet = (SYS_CONSOLE_UART_PLIB_WRITE_COUNT_GET)UART2_WriteCountGet,
	.writeFreeBufferCountGet = (SYS_CONSOLE_UART_PLIB_WRITE_FREE_BUFFER_COUNT_GET)UART2_WriteFreeBufferCountGet,
};

const SYS_CONSOLE_UART_INIT_DATA sysConsole0UARTInitData =
{
    .uartPLIB = &sysConsole0UARTPlibAPI,    
};

const SYS_CONSOLE_INIT sysConsole0Init =
{
    .deviceInitData = (const void*)&sysConsole0UARTInitData,
    .consDevDesc = &sysConsoleUARTDevDesc,
    .deviceIndex = 0,
};



// </editor-fold>




// *****************************************************************************
// *****************************************************************************
// Section: Local initialization functions
// *****************************************************************************
// *****************************************************************************



/*******************************************************************************
  Function:
    void SYS_Initialize ( void *data )

  Summary:
    Initializes the board, services, drivers, application and other modules.

  Remarks:
 */

void SYS_Initialize ( void* data )
{

    /* Start out with interrupts disabled before configuring any modules */
    __builtin_disable_interrupts();

  
    CLK_Initialize();
    
    /* Configure Prefetch, Wait States and ECC */
    PRECONbits.PREFEN = 3;
    PRECONbits.PFMWS = 3;
    CFGCONbits.ECCCON = 3;



	GPIO_Initialize();

    DMAC_Initialize();

	SPI6_Initialize();

    CORETIMER_Initialize();
    I2C2_Initialize();

	UART2_Initialize();

	SPI2_Initialize();


    /* Initialize SDSPI0 Driver Instance */
    sysObj.drvSDSPI0 = DRV_SDSPI_Initialize(DRV_SDSPI_INDEX_0, (SYS_MODULE_INIT *)&drvSDSPI0InitData);

    /* Initialize SPI0 Driver Instance */
    sysObj.drvSPI0 = DRV_SPI_Initialize(DRV_SPI_INDEX_0, (SYS_MODULE_INIT *)&drvSPI0InitData);

    sysObj.sysDebug = SYS_DEBUG_Initialize(SYS_DEBUG_INDEX_0, (SYS_MODULE_INIT*)&debugInit);


    sysObj.sysTime = SYS_TIME_Initialize(SYS_TIME_INDEX_0, (SYS_MODULE_INIT *)&sysTimeInitData);
    sysObj.sysConsole0 = SYS_CONSOLE_Initialize(SYS_CONSOLE_INDEX_0, (SYS_MODULE_INIT *)&sysConsole0Init);

    //CORETIMER_DelayMs(500);
	/* Initialize USB Driver */ 
    sysObj.drvUSBHSObject = DRV_USBHS_Initialize(DRV_USBHS_INDEX_0, (SYS_MODULE_INIT *) &drvUSBInit);	

	/* Initialize the USB Host layer */
    sysObj.usbHostObject0 = USB_HOST_Initialize (( SYS_MODULE_INIT *)& usbHostInitData );	

    /*** File System Service Initialization Code ***/
    SYS_FS_Initialize( (const void *) sysFSInit );


    APP_Initialize();


    EVIC_Initialize();

	/* Enable global interrupts */
    __builtin_enable_interrupts();


}


/*******************************************************************************
 End of File
*/
