meerstern/Usb_Camera_Converter/FIRM/Application/firmware/src/lcd/st7735.c

/** 
 * --------------------------------------------------------------------------------------------+ 
 * @name        ST773 1.8" LCD Driver
 * --------------------------------------------------------------------------------------------+ 
 *              Copyright (C) 2020 Marian Hrinko.
 *              Written by Marian Hrinko (mato.hrinko@gmail.com)
 *
 * @author      Marian Hrinko
 * @datum       13.10.2020
 * @update      01.07.2021
 * @file        st7735.c
 * @version     2.0
 * @tested      AVR Atmega328
 *
 * @depend      font.h
 * --------------------------------------------------------------------------------------------+
 * @descr       Version 1.0 -> applicable for 1 display
 *              Version 2.0 -> applicable for more than 1 display
 * --------------------------------------------------------------------------------------------+
 * @inspir      http://www.displayfuture.com/Display/datasheet/controller/ST7735.pdf
 *              https://github.com/adafruit/Adafruit-ST7735-Library
 *              http://w8bh.net/avr/AvrTFT.pdf
 */

#include <stdio.h>
#include <stddef.h>
#include <stdbool.h>
#include <stdlib.h>            
#include "definitions.h"
#include "font.h"
#include "st7735.h"

#define pgm_read_byte(addr) (*(const unsigned char *)(addr))

/** @array Init command */
const uint8_t INIT_ST7735B[] = {
  // number of initializers
  11,
  // ---------------------------------------
  // Software reset - no arguments,  delay
  0, 150, SWRESET,
  // Out of sleep mode, no arguments, delay
  0, 200, SLPOUT,  
  // Set color mode, 1 argument delay
  1,  10, COLMOD, 0x05,
  // D7  D6  D5  D4  D3  D2  D1  D0
  // MY  MX  MV  ML RGB  MH   -   -
  // ------------------------------
  // ------------------------------
  // MV  MX  MY -> {MV (row / column exchange) MX (column address order), MY (row address order)}
  // ------------------------------
  //  0   0   0 -> begin left-up corner, end right-down corner 
  //               left-right (normal view) 
  //  0   0   1 -> begin left-down corner, end right-up corner 
  //               left-right (Y-mirror)
  //  0   1   0 -> begin right-up corner, end left-down corner 
  //               right-left (X-mirror)
  //  0   1   1 -> begin right-down corner, end left-up corner
  //               right-left (X-mirror, Y-mirror)
  //  1   0   0 -> begin left-up corner, end right-down corner
  //               up-down (X-Y exchange)  
  //  1   0   1 -> begin left-down corner, end right-up corner
  //               down-up (X-Y exchange, Y-mirror)
  //  1   1   0 -> begin right-up corner, end left-down corner 
  //               up-down (X-Y exchange, X-mirror)  
  //  1   1   1 -> begin right-down corner, end left-up corner
  //               down-up (X-Y exchange, X-mirror, Y-mirror)
  // ------------------------------
  //  ML: vertical refresh order 
  //      0 -> refresh top to bottom 
  //      1 -> refresh bottom to top
  // ------------------------------
  // RGB: filter panel
  //      0 -> RGB 
  //      1 -> BGR        
  // ------------------------------ 
  //  MH: horizontal refresh order 
  //      0 -> refresh left to right 
  //      1 -> refresh right to left
  // 0xA0 = 1010 0000
  1,   0, MADCTL, 0x60,
  
  3,   0, FRMCTR1,0x01,0x2C,0x2D,//ADD
  
  3,   0, FRMCTR2,0x01,0x2C,0x2D,//ADD
  
  6,   0, FRMCTR3,0x01,0x2C,0x2D,0x01,0x2C,0x2D,//ADD
  
  2,   0, DISSET5,0x15,0x02,//ADD
  
 16,   0, GMCTRP1,0x02, 0x1c, 0x07, 0x12, 0x37, 0x32, 0x29, 0x2d, 0x29, 0x25, 0x2B, 0x39, 0x00, 0x01, 0x03, 0x10,
 16,   0, GMCTRN1,0x03, 0x1d, 0x07, 0x06, 0x2E, 0x2C, 0x29, 0x2D, 0x2E, 0x2E, 0x37, 0x3F, 0x00, 0x00, 0x02, 0x10,
  
  // Main screen turn on
  0, 200, DISPON 
  // ---------------------------------------
};

/** @var array Chache memory char index row */
unsigned short int cacheMemIndexRow = 0;
/** @var array Chache memory char index column */
unsigned short int cacheMemIndexCol = 0;

/**
 * @desc    Hardware Reset
 *
 * @param   struct signal *
 *
 * @return  void
 */
void ST7735_Reset (struct signal * reset)
{
  // delay 200 ms
  _delay_ms(200);
  // Reset Low 
  CLR_BIT (*(reset->port), reset->pin);
  // delay 200 ms
  _delay_ms(200);
  // Reset High
  SET_BIT (*(reset->port), reset->pin);
}

/**
 * @desc    Init SPI
 *
 * @param   void
 *
 * @return  void
 */
void ST7735_SPI_Init (void)
{

}

/**
 * @desc    Init Pins
 *
 * @param   struct st7735 *
 *
 * @return  void
 */
void ST7735_Pins_Init (struct st7735 * lcd)
{

}

/**
 * @desc    Init st7735 driver
 *
 * @param   struct st7735 *
 *
 * @return  void
 */
void ST7735_Init (struct st7735 * lcd)
{
  // init pins
  ST7735_Pins_Init (lcd);
  // init SPI
  ST7735_SPI_Init ();
  // hardware reset
  ST7735_Reset (lcd->rs);
  // load list of commands
  ST7735_Commands (lcd, INIT_ST7735B);
}

/**
 * @desc    Send list commands
 *
 * @param   struct st7735 *
 * @param   const uint8_t *
 *
 * @return  void
 */
void ST7735_Commands (struct st7735 * lcd, const uint8_t * initializers)
{
  uint8_t args;
  uint8_t cmnd;
  uint8_t time;
  uint8_t loop = pgm_read_byte (initializers++);

  // loop through whole initializer list
  while (loop--) {

    // 1st arg - number of command arguments
    args = pgm_read_byte (initializers++);
    // 2nd arg - delay time
    time = pgm_read_byte (initializers++);
    // 3th arg - command
    cmnd = pgm_read_byte (initializers++);

    // send command
    ST7735_CommandSend (lcd, cmnd);
    // send arguments
    while (args--) {
      // send argument
      ST7735_Data8BitsSend (lcd, pgm_read_byte (initializers++));
    }
    // delay
    ST7735_DelayMs (time);
  }
}

/**
 * @desc    Command send
 *
 * @param   struct st7735 *
 * @param   uint8_t
 *
 * @return void
 */
uint8_t ST7735_CommandSend (struct st7735 * lcd, uint8_t data)
{
  // chip enable - active low
  CLR_BIT (*(lcd->cs->port), lcd->cs->pin);
  // command (active low)
  CLR_BIT (*(lcd->dc->port), lcd->dc->pin);
  // transmitting data
  SPDR = data;
  // wait till data transmit
  WAIT_UNTIL_BIT_IS_SET (SPSR, SPIF);
  // chip disable - idle high
  SET_BIT (*(lcd->cs->port), lcd->cs->pin);
  // return received data
  return SPDR;
}

/**
 * @desc    8bits data send
 *
 * @param   struct st7735 *
 * @param   uint8_t
 *
 * @return  void
 */
uint8_t ST7735_Data8BitsSend (struct st7735 * lcd, uint8_t data)
{
  // chip enable - active low
  CLR_BIT (*(lcd->cs->port), lcd->cs->pin);
  // data (active high)
  SET_BIT (*(lcd->dc->port), lcd->dc->pin);
  // transmitting data
  SPDR = data;
  // wait till data transmit
  WAIT_UNTIL_BIT_IS_SET (SPSR, SPIF);
  // chip disable - idle high
  SET_BIT (*(lcd->cs->port), lcd->cs->pin);
  // return received data
  return SPDR;
}

/**
 * @desc    16bits data send
 *
 * @param   struct st7735 * lcd
 * @param   uint16_t
 *
 * @return  void
 */
uint8_t ST7735_Data16BitsSend (struct st7735 * lcd, uint16_t data)
{
  // chip enable - active low
  CLR_BIT (*(lcd->cs->port), lcd->cs->pin);
  // data (active high)
  SET_BIT (*(lcd->dc->port), lcd->dc->pin);
  // transmitting data high byte
  SPDR = (uint8_t) (data >> 8);
  // wait till high byte transmit
  WAIT_UNTIL_BIT_IS_SET (SPSR, SPIF);
  // transmitting data low byte
  SPDR = (uint8_t) (data);
  // wait till low byte transmit
  WAIT_UNTIL_BIT_IS_SET (SPSR, SPIF);
  // chip disable - idle high
  SET_BIT (*(lcd->cs->port), lcd->cs->pin);
  // return received data
  return SPDR;
}

/**
 * @desc    Set window
 *
 * @param   struct st7735 * lcd
 * @param   uint8_t x - start position
 * @param   uint8_t x - end position
 * @param   uint8_t y - start position
 * @param   uint8_t y - end position
 *
 * @return  uint8_t
 */
uint8_t ST7735_SetWindow (struct st7735 * lcd, uint8_t x0, uint8_t x1, uint8_t y0, uint8_t y1)
{
  // check if coordinates is out of range
  if ((x0 > x1)     ||
      (x1 > SIZE_X) ||
      (y0 > y1)     ||
      (y1 > SIZE_Y)) { 
    // out of range
    return ST7735_ERROR;
  }  
  // column address set
  ST7735_CommandSend (lcd, CASET);
  // send start x position
  ST7735_Data16BitsSend (lcd, 0x0000 | x0);
  // send end x position
  ST7735_Data16BitsSend (lcd, 0x0000 | x1);

  // row address set
  ST7735_CommandSend (lcd, RASET);
  // send start y position
  ST7735_Data16BitsSend (lcd, 0x0000 | y0);
  // send end y position
  ST7735_Data16BitsSend (lcd, 0x0000 | y1);

  //SYS_DEBUG_PRINT(SYS_ERROR_WARNING, "X:0x%LX,Y:0x%LX\r\n",x1,y1); 
  
  ST7735_CommandSend (lcd, RAMWR);
  // success
  return ST7735_SUCCESS;
}

/**
 * @desc    Write color pixels
 *
 * @param   struct st7735 * lcd
 * @param   uint16_t color
 * @param   uint16_t counter
 *
 * @return  void
 */
void ST7735_SendColor565 (struct st7735 * lcd, uint16_t color, uint16_t count)
{
  // access to RAM
  ST7735_CommandSend (lcd, RAMWR);
  // counter
  while (count--) {
    // write color
    ST7735_Data16BitsSend (lcd, color);
  }
}

/**
 * @desc    Draw pixel
 *
 * @param   struct st7735 * lcd
 * @param   uint8_t x position / 0 <= cols <= MAX_X-1
 * @param   uint8_t y position / 0 <= rows <= MAX_Y-1
 * @param   uint16_t color
 *
 * @return  void
 */
void ST7735_DrawPixel (struct st7735 * lcd, uint8_t x, uint8_t y, uint16_t color)
{
  // set window
  ST7735_SetWindow (lcd, x, x, y, y);
  // draw pixel by 565 mode
  ST7735_SendColor565 (lcd, color, 1);
}

/**
 * @desc    RAM Content Show
 *
 * @param   struct st7735 * lcd
 *
 * @return  void
 */
void ST7735_RAM_Content_Show (struct st7735 * lcd)
{
  // display content on
  ST7735_CommandSend (lcd, DISPON);
}

/**
 * @desc    RAM Content Hide
 *
 * @param   struct st7735 * lcd
 *
 * @return  void
 */
void ST7735_RAM_Content_Hide (struct st7735 * lcd)
{
  // display content off
  ST7735_CommandSend (lcd, DISPOFF);
}

/**
 * @desc    Clear screen
 *
 * @param   struct st7735 *
 * @param   uint16_t color
 *
 * @return  void
 */
void ST7735_ClearScreen (struct st7735 * lcd, uint16_t color)
{
  // set whole window
  ST7735_SetWindow (lcd, 0, SIZE_X, 0, SIZE_Y);
  // draw individual pixels
  ST7735_SendColor565 (lcd, color, CACHE_SIZE_MEM);
}

/**
 * @desc    Draw character
 *
 * @param   struct st7735 *
 * @param   char character
 * @param   uint16_t color
 * @param   enum Size (X1, X2, X3)
 *
 * @return  void
 */
char ST7735_DrawChar (struct st7735 * lcd, char character, uint16_t color, enum Size size)
{
  // variables
  uint8_t letter, idxCol, idxRow;
  // check if character is out of range
  if ((character < 0x20) &&
      (character > 0x7f)) { 
    // out of range
    return 0;
  }
  // last column of character array - 5 columns 
  idxCol = CHARS_COLS_LEN;
  // last row of character array - 8 rows / bits
  idxRow = CHARS_ROWS_LEN;

  // --------------------------------------
  // SIZE X1 - normal font 1x high, 1x wide
  // --------------------------------------
  if (size == X1) {  
    // loop through 5 bits
    while (idxCol--) {
      // read from ROM memory 
      letter = pgm_read_byte (&FONTS[character - 32][idxCol]);
      // loop through 8 bits
      while (idxRow--) {
        // check if bit set
        if (letter & (1 << idxRow)) {
          // draw pixel 
          ST7735_DrawPixel (lcd, cacheMemIndexCol + idxCol, cacheMemIndexRow + idxRow, color);
        }
      }
      // fill index row again
      idxRow = CHARS_ROWS_LEN;
    }
    // update x position
    cacheMemIndexCol = cacheMemIndexCol + CHARS_COLS_LEN + 1;
  
  // --------------------------------------
  // SIZE X2 - font 2x higher, normal wide
  // --------------------------------------
  } else if (size == X2) {
    // loop through 5 bytes
    while (idxCol--) {
      // read from ROM memory 
      letter = pgm_read_byte (&FONTS[character - 32][idxCol]);
      // loop through 8 bits
      while (idxRow--) {
        // check if bit set
        if (letter & (1 << idxRow)) {
          // draw first left up pixel; 
          // (idxRow << 1) - 2x multiplied 
          ST7735_DrawPixel (lcd, cacheMemIndexCol + idxCol, cacheMemIndexRow + (idxRow << 1), color);
          // draw second left down pixel
          ST7735_DrawPixel (lcd, cacheMemIndexCol + idxCol, cacheMemIndexRow + (idxRow << 1) + 1, color);
        }
      }
      // fill index row again
      idxRow = CHARS_ROWS_LEN;
    }
    // update x position
    cacheMemIndexCol = cacheMemIndexCol + CHARS_COLS_LEN + 1;

  // --------------------------------------
  // SIZE X3 - font 2x higher, 2x wider
  // --------------------------------------
  } else if (size == X3) {
    // loop through 5 bytes
    while (idxCol--) {
      // read from ROM memory 
      letter = pgm_read_byte (&FONTS[character - 32][idxCol]);
      // loop through 8 bits
      while (idxRow--) {
        // check if bit set
        if (letter & (1 << idxRow)) {
          // draw first left up pixel; 
          // (idxRow << 1) - 2x multiplied 
          ST7735_DrawPixel (lcd, cacheMemIndexCol + (idxCol << 1), cacheMemIndexRow + (idxRow << 1), color);
          // draw second left down pixel
          ST7735_DrawPixel (lcd, cacheMemIndexCol + (idxCol << 1), cacheMemIndexRow + (idxRow << 1) + 1, color);
          // draw third right up pixel
          ST7735_DrawPixel (lcd, cacheMemIndexCol + (idxCol << 1) + 1, cacheMemIndexRow + (idxRow << 1), color);
          // draw fourth right down pixel
          ST7735_DrawPixel (lcd, cacheMemIndexCol + (idxCol << 1) + 1, cacheMemIndexRow + (idxRow << 1) + 1, color);
        }
      }
      // fill index row again
      idxRow = CHARS_ROWS_LEN;
    }

    // update x position
    cacheMemIndexCol = cacheMemIndexCol + CHARS_COLS_LEN + CHARS_COLS_LEN + 1;
  }

  // return exit
  return ST7735_SUCCESS;
}

/**
 * @desc    Set text position x, y
 *
 * @param   uint8_t x - position
 * @param   uint8_t y - position
 *
 * @return  char
 */
char ST7735_SetPosition (uint8_t x, uint8_t y)
{
  // check if coordinates is out of range
  if ((x > MAX_X) && (y > MAX_Y)) {
    // error
    return ST7735_ERROR;

  } else if ((x > MAX_X) && (y <= MAX_Y)) {
    // set position y
    cacheMemIndexRow = y;
    // set position x
    cacheMemIndexCol = 2;
  } else {
    // set position y 
    cacheMemIndexRow = y;
    // set position x
    cacheMemIndexCol = x;
  }
  // success
  return ST7735_SUCCESS;
}

/**
 * @desc    Check text position x, y
 *
 * @param   unsigned char x - position
 * @param   unsigned char y - position
 * @param   unsigned char
 *
 * @return  char
 */
char ST7735_CheckPosition (unsigned char x, unsigned char y, unsigned char max_y, enum Size size)
{
  // check if coordinates is out of range
  if ((x > MAX_X) && (y > max_y)) {
    // out of range
    return ST7735_ERROR;

  }
  // if next line
  if ((x > MAX_X) && (y <= max_y)) {
    // set position y
    cacheMemIndexRow = y;
    // set position x
    cacheMemIndexCol = 2;
  } 

  // success
  return ST7735_SUCCESS;
}

/**
 * @desc    Draw string
 *
 * @param   struct st7735 *
 * @param   char * string 
 * @param   uint16_t color
 * @param   enum Size (X1, X2, X3)
 *
 * @return  void
 */
void ST7735_DrawString (struct st7735 * lcd, char *str, uint16_t color, enum Size size)
{
  // variables
  unsigned int i = 0;
  unsigned char check;
  unsigned char delta_y;
  unsigned char max_y_pos;
  unsigned char new_x_pos;
  unsigned char new_y_pos;

  // loop through character of string
  while (str[i] != '\0') {
    // max x position character
    new_x_pos = cacheMemIndexCol + CHARS_COLS_LEN + (size & 0x0F);
    // delta y
    delta_y = CHARS_ROWS_LEN + (size >> 4);
    // max y position character
    new_y_pos = cacheMemIndexRow + delta_y;
    // max y pos
    max_y_pos = MAX_Y - delta_y;
    // control if will be in range
    check = ST7735_CheckPosition (new_x_pos, new_y_pos, max_y_pos, size);
    // update position
    if (ST7735_SUCCESS == check) {
      // read characters and increment index
      ST7735_DrawChar (lcd, str[i++], color, size);
    }
  }
}

/**
 * @desc    Draw line by Bresenham algoritm
 * @surce   https://en.wikipedia.org/wiki/Bresenham%27s_line_algorithm
 *  
 * @param   struct st7735 *
 * @param   uint8_t x start position / 0 <= cols <= MAX_X-1
 * @param   uint8_t x end position   / 0 <= cols <= MAX_X-1
 * @param   uint8_t y start position / 0 <= rows <= MAX_Y-1 
 * @param   uint8_t y end position   / 0 <= rows <= MAX_Y-1
 * @param   uint16_t color
 *
 * @return  void
 */
char ST7735_DrawLine (struct st7735 * lcd, uint8_t x1, uint8_t x2, uint8_t y1, uint8_t y2, uint16_t color)
{
  // determinant
  int16_t D;
  // deltas
  int16_t delta_x, delta_y;
  // steps
  int16_t trace_x = 1, trace_y = 1;

  // delta x
  delta_x = x2 - x1;
  // delta y
  delta_y = y2 - y1;

  // check if x2 > x1
  if (delta_x < 0) {
    // negate delta x
    delta_x = -delta_x;
    // negate step x
    trace_x = -trace_x;
  }

  // check if y2 > y1
  if (delta_y < 0) {
    // negate detla y
    delta_y = -delta_y;
    // negate step y
    trace_y = -trace_y;
  }

  // Bresenham condition for m < 1 (dy < dx)
  if (delta_y < delta_x) {
    // calculate determinant
    D = (delta_y << 1) - delta_x;
    // draw first pixel
    ST7735_DrawPixel (lcd, x1, y1, color);
    // check if x1 equal x2
    while (x1 != x2) {
      // update x1
      x1 += trace_x;
      // check if determinant is positive
      if (D >= 0) {
        // update y1
        y1 += trace_y;
        // update determinant
        D -= 2*delta_x;    
      }
      // update deteminant
      D += 2*delta_y;
      // draw next pixel
      ST7735_DrawPixel (lcd, x1, y1, color);
    }
  // for m > 1 (dy > dx)    
  } else {
    // calculate determinant
    D = delta_y - (delta_x << 1);
    // draw first pixel
    ST7735_DrawPixel (lcd, x1, y1, color);
    // check if y2 equal y1
    while (y1 != y2) {
      // update y1
      y1 += trace_y;
      // check if determinant is positive
      if (D <= 0) {
        // update y1
        x1 += trace_x;
        // update determinant
        D += 2*delta_y;    
      }
      // update deteminant
      D -= 2*delta_x;
      // draw next pixel
      ST7735_DrawPixel (lcd, x1, y1, color);
    }
  }
  // success return
  return 1;
}

/**
 * @desc    Fast draw line horizontal
 *
 * @param   struct st7735 *
 * @param   uint8_t xs - start position
 * @param   uint8_t xe - end position
 * @param   uint8_t y - position
 * @param   uint16_t color
 *
 * @return void
 */
void ST7735_DrawLineHorizontal (struct st7735 * lcd, uint8_t xs, uint8_t xe, uint8_t y, uint16_t color)
{
  uint8_t temp;
  // check if start is > as end  
  if (xs > xe) {
    // temporary safe
    temp = xs;
    // start change for end
    xe = xs;
    // end change for start
    xs = temp;
  }
  // set window
  ST7735_SetWindow (lcd, xs, xe, y, y);
  // draw pixel by 565 mode
  ST7735_SendColor565 (lcd, color, xe - xs);
}

/**
 * @desc    Fast draw line vertical
 *
 * @param   struct st7735 *
 * @param   uint8_t x - position
 * @param   uint8_t ys - start position
 * @param   uint8_t ye - end position
 * @param   uint16_t color
 *
 * @return  void
 */
void ST7735_DrawLineVertical (struct st7735 * lcd, uint8_t x, uint8_t ys, uint8_t ye, uint16_t color)
{
  uint8_t temp;
  // check if start is > as end
  if (ys > ye) {
    // temporary safe
    temp = ys;
    // start change for end
    ye = ys;
    // end change for start
    ys = temp;
  }
  // set window
  ST7735_SetWindow (lcd, x, x, ys, ye);
  // draw pixel by 565 mode
  ST7735_SendColor565 (lcd, color, ye - ys);
}

/**
 * @desc    Draw rectangle
 *
 * @param   struct st7735 *
 * @param   uint8_t x start position
 * @param   uint8_t x end position
 * @param   uint8_t y start position
 * @param   uint8_t y end position
 * @param   uint16_t color
 *
 * @return  void
 */
void ST7735_DrawRectangle (struct st7735 * lcd, uint8_t xs, uint8_t xe, uint8_t ys, uint8_t ye, uint16_t color)
{
  uint8_t temp;
  // check if start is > as end  
  if (xs > xe) {
    // temporary safe
    temp = xe;
    // start change for end
    xe = xs;
    // end change for start
    xs = temp;
  }
  // check if start is > as end
  if (ys > ye) {
    // temporary safe
    temp = ye;
    // start change for end
    ye = ys;
    // end change for start
    ys = temp;
  }
  // set window
  ST7735_SetWindow (lcd, xs, xe, ys, ye);
  // send color
  ST7735_SendColor565 (lcd, color, (xe-xs+1)*(ye-ys+1));  
}

/**
 * @desc    Delay
 *
 * @param   uint8_t time in milliseconds / max 256ms
 *
 * @return  void
 */
void ST7735_DelayMs (uint8_t time)
{
  // loop through real time
  while (time--) {
    // 1 s delay
    _delay_ms(1);
  }
}
