meerstern/Usb_Camera_Converter/FIRM/Application/firmware/src/jpeg.c

/*
 * jpeg.c
 *
 *  Created on: 2021/09/05
 *      Author: MOND
 */
#include <stdint.h>
#include <stdlib.h>
#include <string.h>
#include <stdbool.h>
#include "configuration.h"
#include "jpeg.h"
#include "system/debug/sys_debug.h"

#ifdef ENABLE_JPGDECODE
    #include "tjpgd/tjpgd.h"



    typedef struct {
       
        uint8_t *fbuf;          /* Output frame buffer */
        unsigned int wfbuf;     /* Width of the frame buffer [pix] */
    } IODEV;

    uint32_t    TjpgdWorkArea[TJPGD_WORKSIZE];
    uint8_t     TjpgdBmp[N_BPP*TJPGD_BMP_MAX_HIGHT*TJPGD_BMP_MAX_WIDTH];
    uint8_t     *TjpgdJpgData;
    uint32_t    TjpgdJpgSize;
    uint32_t    TjpgdJpgOffset;
    volatile uint8_t    TjpgdScale=0;
    /* tjpgd obj */
    
    JDEC jdec;
    IODEV devid;
    
#endif





const uint8_t huffmanTable[420] =
{
	0xFF,0xC4,0x01,0xA2,0x00,0x00,0x01,0x05,0x01,0x01,0x01,0x01,0x01,0x01,0x00,0x00,
	0x00,0x00,0x00,0x00,0x00,0x00,0x01,0x02,0x03,0x04,0x05,0x06,0x07,0x08,0x09,0x0A,
	0x0B,0x01,0x00,0x03,0x01,0x01,0x01,0x01,0x01,0x01,0x01,0x01,0x01,0x00,0x00,0x00,
	0x00,0x00,0x00,0x01,0x02,0x03,0x04,0x05,0x06,0x07,0x08,0x09,0x0A,0x0B,0x10,0x00,
	0x02,0x01,0x03,0x03,0x02,0x04,0x03,0x05,0x05,0x04,0x04,0x00,0x00,0x01,0x7D,0x01,
	0x02,0x03,0x00,0x04,0x11,0x05,0x12,0x21,0x31,0x41,0x06,0x13,0x51,0x61,0x07,0x22,
	0x71,0x14,0x32,0x81,0x91,0xA1,0x08,0x23,0x42,0xB1,0xC1,0x15,0x52,0xD1,0xF0,0x24,
	0x33,0x62,0x72,0x82,0x09,0x0A,0x16,0x17,0x18,0x19,0x1A,0x25,0x26,0x27,0x28,0x29,
	0x2A,0x34,0x35,0x36,0x37,0x38,0x39,0x3A,0x43,0x44,0x45,0x46,0x47,0x48,0x49,0x4A,
	0x53,0x54,0x55,0x56,0x57,0x58,0x59,0x5A,0x63,0x64,0x65,0x66,0x67,0x68,0x69,0x6A,
	0x73,0x74,0x75,0x76,0x77,0x78,0x79,0x7A,0x83,0x84,0x85,0x86,0x87,0x88,0x89,0x8A,
	0x92,0x93,0x94,0x95,0x96,0x97,0x98,0x99,0x9A,0xA2,0xA3,0xA4,0xA5,0xA6,0xA7,0xA8,
	0xA9,0xAA,0xB2,0xB3,0xB4,0xB5,0xB6,0xB7,0xB8,0xB9,0xBA,0xC2,0xC3,0xC4,0xC5,0xC6,
	0xC7,0xC8,0xC9,0xCA,0xD2,0xD3,0xD4,0xD5,0xD6,0xD7,0xD8,0xD9,0xDA,0xE1,0xE2,0xE3,
	0xE4,0xE5,0xE6,0xE7,0xE8,0xE9,0xEA,0xF1,0xF2,0xF3,0xF4,0xF5,0xF6,0xF7,0xF8,0xF9,
	0xFA,0x11,0x00,0x02,0x01,0x02,0x04,0x04,0x03,0x04,0x07,0x05,0x04,0x04,0x00,0x01,
	0x02,0x77,0x00,0x01,0x02,0x03,0x11,0x04,0x05,0x21,0x31,0x06,0x12,0x41,0x51,0x07,
	0x61,0x71,0x13,0x22,0x32,0x81,0x08,0x14,0x42,0x91,0xA1,0xB1,0xC1,0x09,0x23,0x33,
	0x52,0xF0,0x15,0x62,0x72,0xD1,0x0A,0x16,0x24,0x34,0xE1,0x25,0xF1,0x17,0x18,0x19,
	0x1A,0x26,0x27,0x28,0x29,0x2A,0x35,0x36,0x37,0x38,0x39,0x3A,0x43,0x44,0x45,0x46,
	0x47,0x48,0x49,0x4A,0x53,0x54,0x55,0x56,0x57,0x58,0x59,0x5A,0x63,0x64,0x65,0x66,
	0x67,0x68,0x69,0x6A,0x73,0x74,0x75,0x76,0x77,0x78,0x79,0x7A,0x82,0x83,0x84,0x85,
	0x86,0x87,0x88,0x89,0x8A,0x92,0x93,0x94,0x95,0x96,0x97,0x98,0x99,0x9A,0xA2,0xA3,
	0xA4,0xA5,0xA6,0xA7,0xA8,0xA9,0xAA,0xB2,0xB3,0xB4,0xB5,0xB6,0xB7,0xB8,0xB9,0xBA,
	0xC2,0xC3,0xC4,0xC5,0xC6,0xC7,0xC8,0xC9,0xCA,0xD2,0xD3,0xD4,0xD5,0xD6,0xD7,0xD8,
	0xD9,0xDA,0xE2,0xE3,0xE4,0xE5,0xE6,0xE7,0xE8,0xE9,0xEA,0xF2,0xF3,0xF4,0xF5,0xF6,
	0xF7,0xF8,0xF9,0xFA
};

#ifdef ENABLE_JPGDECODE

size_t jpegDecodeInput( JDEC* jd, uint8_t* buff, size_t nbyte )
{
    IODEV *dev = (IODEV*)jd->device; 
    
    if(buff)
    {
        memmove(buff, TjpgdJpgData+TjpgdJpgOffset, nbyte);
        TjpgdJpgOffset=TjpgdJpgOffset+nbyte;     
        return nbyte;
    }
    else
    {
        TjpgdJpgOffset=TjpgdJpgOffset+nbyte;     
        return nbyte;
    }
}

int jpegDecodeOutput( JDEC* jd, void* bitmap, JRECT* rect )
{
    IODEV *dev = (IODEV*)jd->device; 
    uint8_t *src, *dst;
    uint16_t y, bws;
    unsigned int bwd;
    
        /* Put progress indicator */
    if (rect->left == 0)
    {
        //SYS_DEBUG_PRINT(SYS_ERROR_WARNING, "Prgrss:%lu%%\r\n",
        //        (rect->top << jd->scale) * 100UL / jd->height);
    }

    /* Copy the output image rectanglar to the frame buffer */
    src = (uint8_t*)bitmap;
    dst = dev->fbuf + N_BPP * (rect->top * dev->wfbuf + rect->left);  /* Left-top of destination rectangular */
    bws = N_BPP * (rect->right - rect->left + 1);     /* Width of output rectangular [byte] */
    bwd = N_BPP * dev->wfbuf;                         /* Width of frame buffer [byte] */
    for (y = rect->top; y <= rect->bottom; y++) {
        memcpy(dst, src, bws);   /* Copy a line */
        src += bws; dst += bwd;  /* Next line */
    }

    return 1;    /* Continue to decompress */
}


bool JpegDecodeProcess(uint8_t *jpgData, uint32_t jpgDataSize, uint8_t scale)
{
    JRESULT res;
    
    TjpgdScale=scale;
    TjpgdJpgData=jpgData;
    TjpgdJpgSize=jpgDataSize;
    TjpgdJpgOffset=0;

    res = jd_prepare(&jdec, jpegDecodeInput, TjpgdWorkArea, TJPGD_WORKSIZE, &devid);
    if (res == JDR_OK)
    {
        //SYS_DEBUG_PRINT(SYS_ERROR_WARNING, "Image size is %u x %u.\r\n%u bytes of work ares is used.\r\n",
        //         jdec.width, jdec.height, (unsigned int)(TJPGD_WORKSIZE - jdec.sz_pool)    );    
        devid.fbuf = TjpgdBmp;
        devid.wfbuf = jdec.width;
        
        res = jd_decomp(&jdec, jpegDecodeOutput, TjpgdScale);
        
        if (res == JDR_OK)
		{
            //SYS_DEBUG_PRINT(SYS_ERROR_WARNING, "Decompression succeeded.\r\n");
            return true;
        }
        else
        {
           //SYS_DEBUG_PRINT(SYS_ERROR_WARNING, "jd_decomp() failed (rc=%d)\r\n",res);
           //while(1);
            return false;
        }
    }
    else
    {
        //SYS_DEBUG_PRINT(SYS_ERROR_WARNING, "jd_prepare() failed (rc=%d)\r\n",res);
        //while(1);
        return false;
    }
    return false;
}

void JpegDecodeBmpData(uint8_t *data, uint32_t *size)
{
    data=TjpgdBmp;
    *size=sizeof(TjpgdBmp)/sizeof(TjpgdBmp[0]);
}




#endif

void JpegSwapForLcd(uint16_t *data)
{
    uint16_t d= *data;
    uint16_t rb=d&0x001F;
    uint16_t g=d&0x07E0;
    uint16_t br=(d>>11)&0x001F;    
    *data=g+br+(rb<<11);
}
