meerstern/Usb_Camera_Converter/(commit log)

2022-03-23 Add PCB Files
    [wcc-B_Cu.gbl, wcc-B_Mask.gbs, wcc-B_Paste.gbp, wcc-B_SilkS.gbo, wcc-Edge_Cuts.gm1, wcc-F_Cu.gtl, wcc-F_Mask.gts, wcc-F_Paste.gtp]
2022-04-17 Add Tested Camera list
    [TestedCamera.csv]
2022-04-19 Add firm
    [configuration.h]
2022-04-20 add じふぃまっげ
2022-04-20 Revert "add じふぃまっげ"
    This reverts commit 6ead67896466d1b7939286707e8fd9013db0f11c.
2022-10-04 Add Monochrome Mode for Bitmap
    [configuration.h]
